gokturkbabaoglu/dumble-clone/parca-gorselleri/README.md

# Parça görselleri

Satıcı sayfalarından alınmış ürün görselleri ve çizimler. Çizimdeki ölçüler satıcınındır; **elindeki parçayla kumpasla doğrulanmadan kesin sayılmamalı**.

| Dosya | Parça | Not |
|---|---|---|
| `01_giris_jaki_6.35mm_olculer.png` | J1, 6,35 mm jak | Ölçü çizimi ve PCB delik planı |
| `02_giris_jaki_6.35mm_bacaklar.png` | J1, 6,35 mm jak | Bacak görevleri (görsel stereo sürüm; elindeki mono, 3 bacaklı) |
| `03_kulaklik_jaki_PJ-324_olculer.png` | J2, PJ-324M | Ölçü çizimi ve PCB yerleşimi |
| `04_kulaklik_jaki_PJ-324_bacaklar.png` | J2, PJ-324M | Bacak numaraları ve kesici kontaklar |
| `05_dc_jak_panel_3uclu.png` | DC giriş jakı | Panel tipi, 3 uçlu |
| `06_guc_anahtari_kirmizi_ON-ON_6bacak.png` | SW2 güç anahtarı | Kırmızı, ON-ON, 6 bacak |
| `07_SW1_mavi_anahtar_3bacak.png` | SW1 Dark/Normal/Bright | Mavi, 3 bacak. Kullanıcı ON-OFF-ON dedi; görselde gövdede "ON ON" yazıyor, orta konumu elindeki parçada doğrula |
| `08_TDA2003_klips_sogutucu.png` | U2 soğutucu | Klips tipi |

Potların, elektrolitiklerin ve sigorta yuvasının görseli yok.
