gokturkbabaoglu/dumble-clone/docs/6_toner_transfer_1e1.pdf

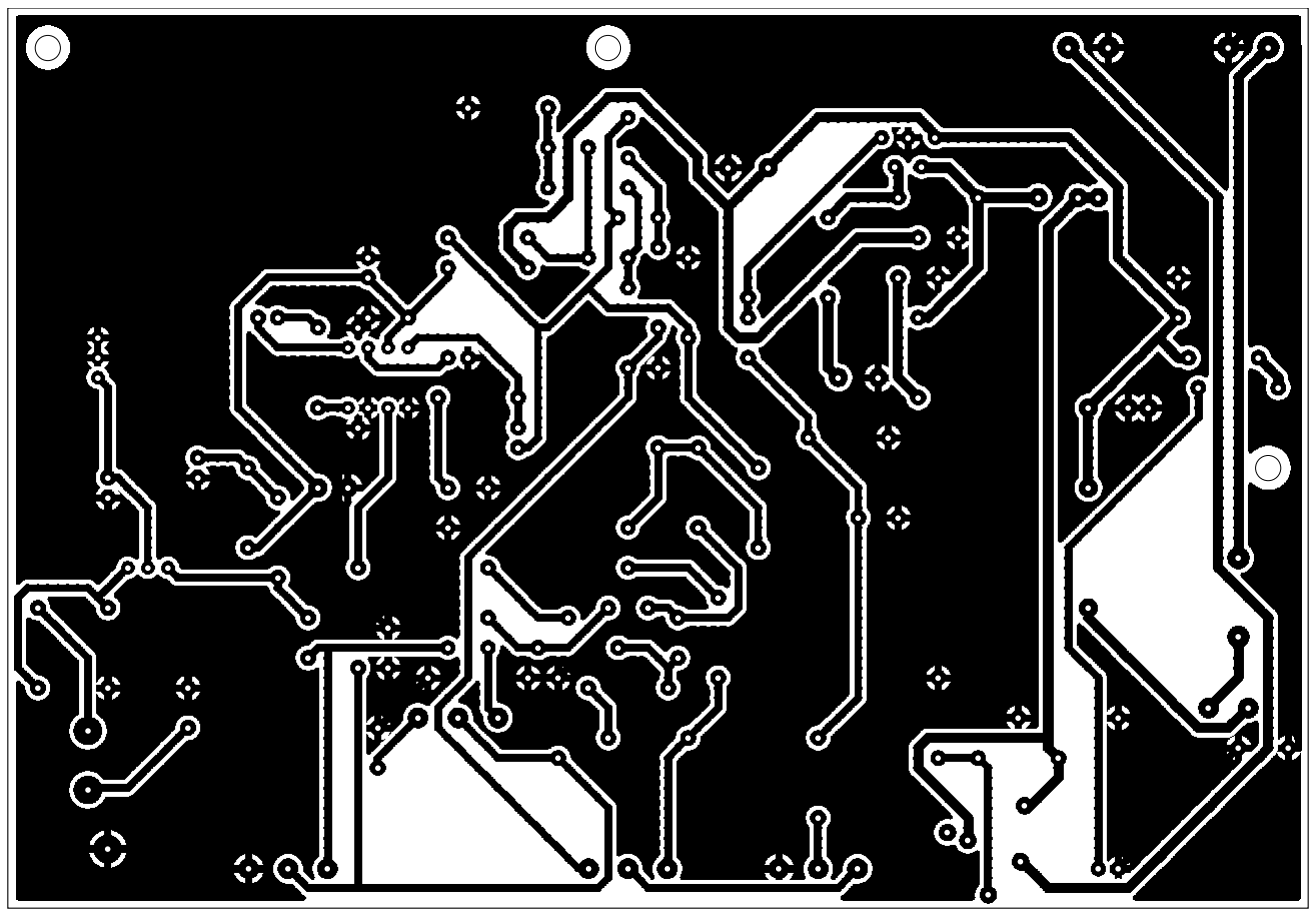
[picture p10: figure]

0 | 10 | 20 | 30 | 40 | 50

# 12V Gitar Amfisi v2 — BAKIR KATMANI, TONER TRANSFERİ İÇİN (1:1)

Yazdırırken ölçeklendirme KAPALI (%100 / Gerçek boyut). 50 mm cetvelini kumpasla kontrol et.

Bu görüntü zaten doğru yönde: kâğıt yüzü bakıra gelecek şekilde konunca bakırda alttan bakış oluşur.

Kart ölçüsü: 165.1 × 114.3 mm. Delmeden önce: jakları, potları ve büyük elkoları bu çıktının ön yüz görseliyle karşılaştır.
