gokturkbabaoglu/dumble-clone/parca-gorselleri/01_giris_jaki_6.35mm_olculer.png

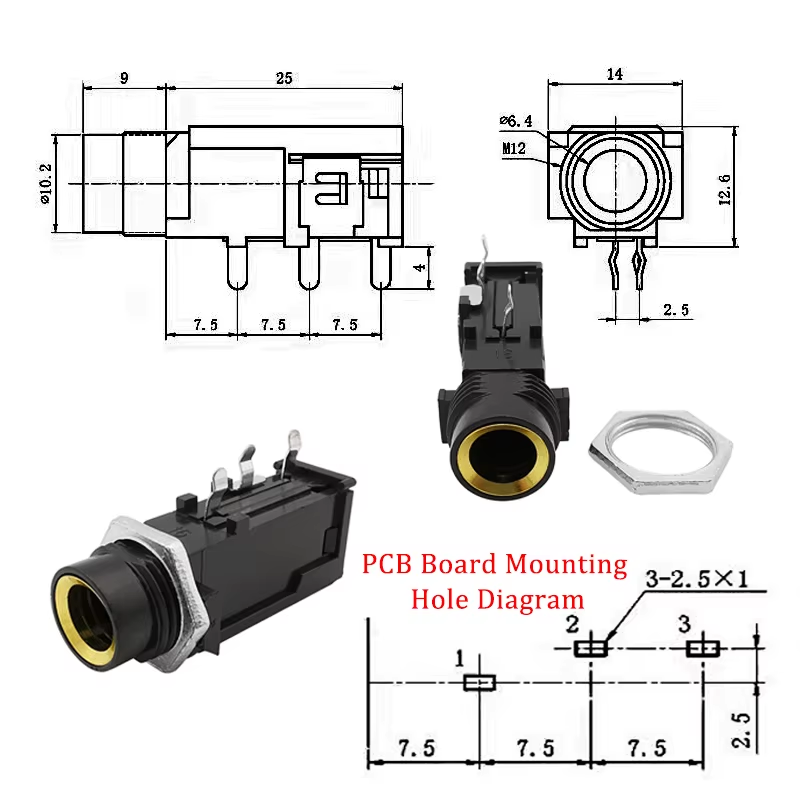
parca-gorselleri/01_giris_jaki_6.35mm_olculer.png
