gokturkbabaoglu/dumble-clone/parca-gorselleri/02_giris_jaki_6.35mm_bacaklar.png

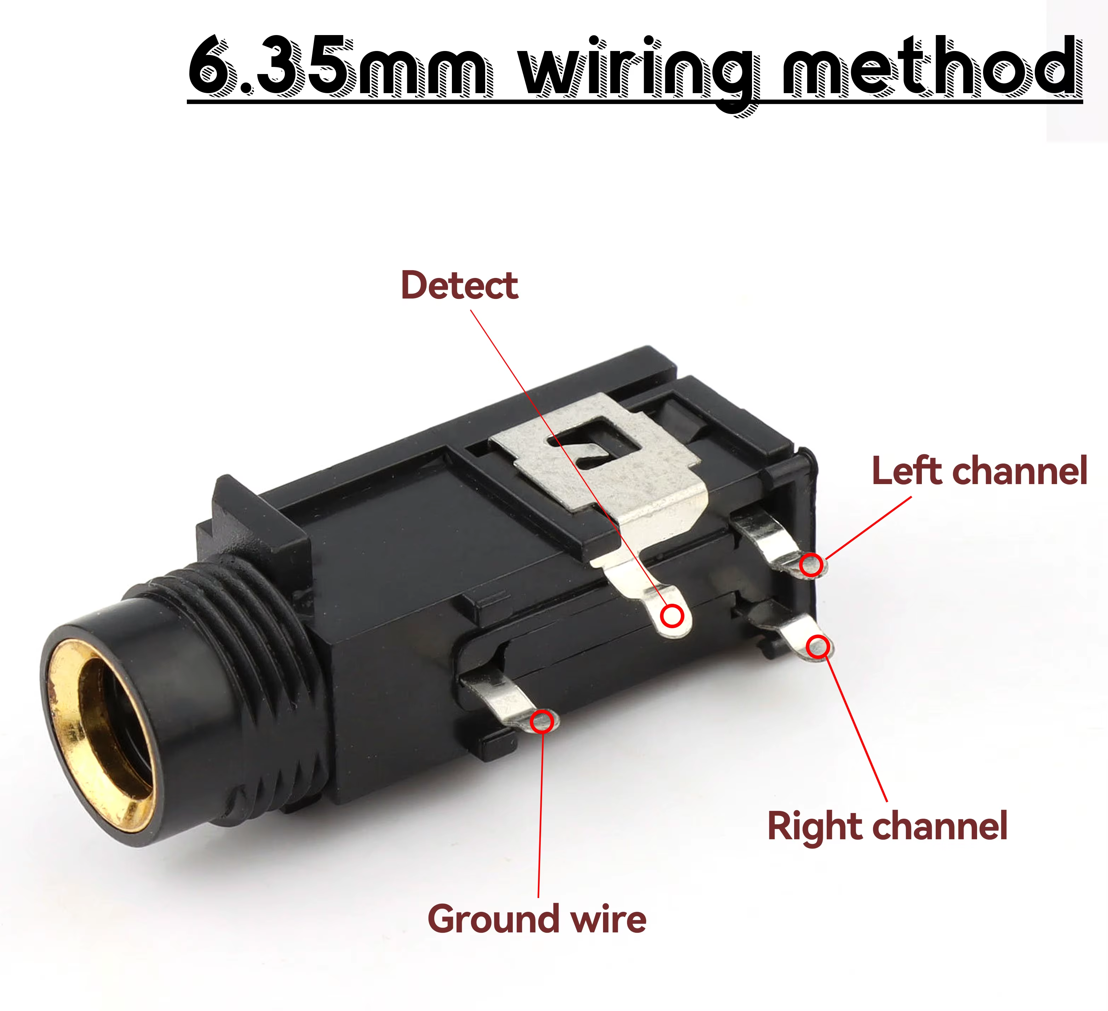
parca-gorselleri/02_giris_jaki_6.35mm_bacaklar.png
