gokturkbabaoglu/dumble-clone/parca-gorselleri/03_kulaklik_jaki_PJ-324_olculer.png

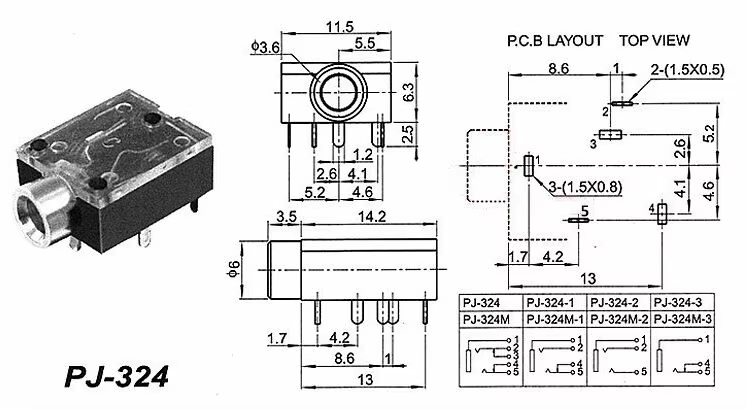
parca-gorselleri/03_kulaklik_jaki_PJ-324_olculer.png
