gokturkbabaoglu/dumble-clone/parca-gorselleri/04_kulaklik_jaki_PJ-324_bacaklar.png

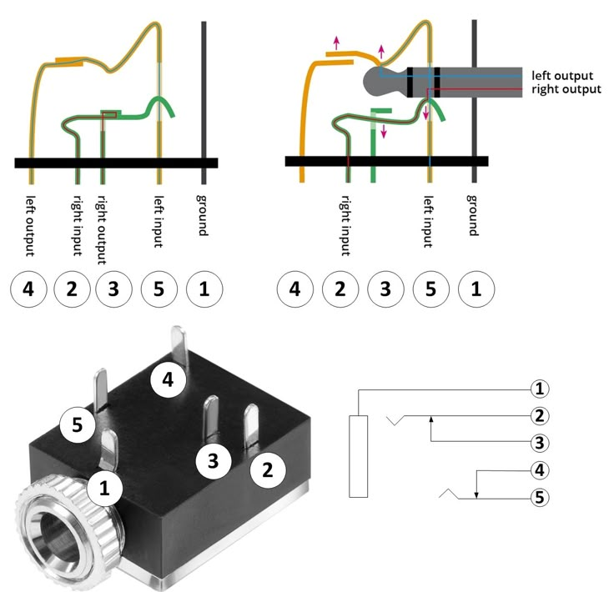
parca-gorselleri/04_kulaklik_jaki_PJ-324_bacaklar.png
