gokturkbabaoglu/dumble-clone/parca-gorselleri/05_dc_jak_panel_3uclu.png

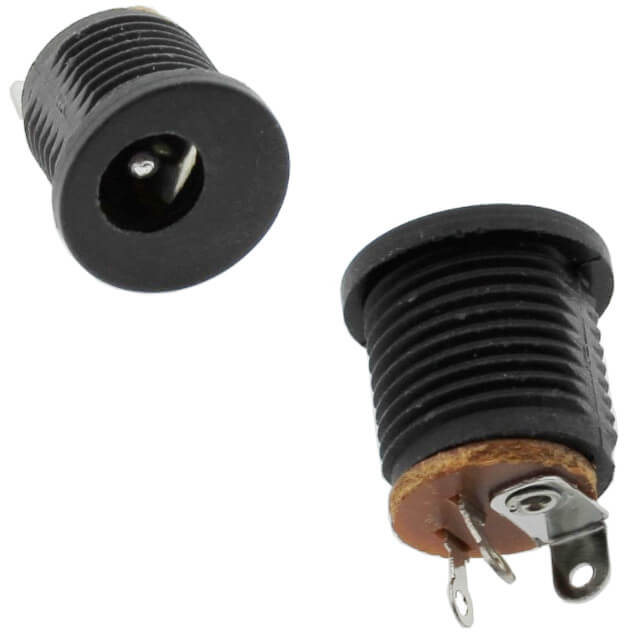
parca-gorselleri/05_dc_jak_panel_3uclu.png
