gokturkbabaoglu/dumble-clone/parca-gorselleri/06_guc_anahtari_kirmizi_ON-ON_6bacak.png

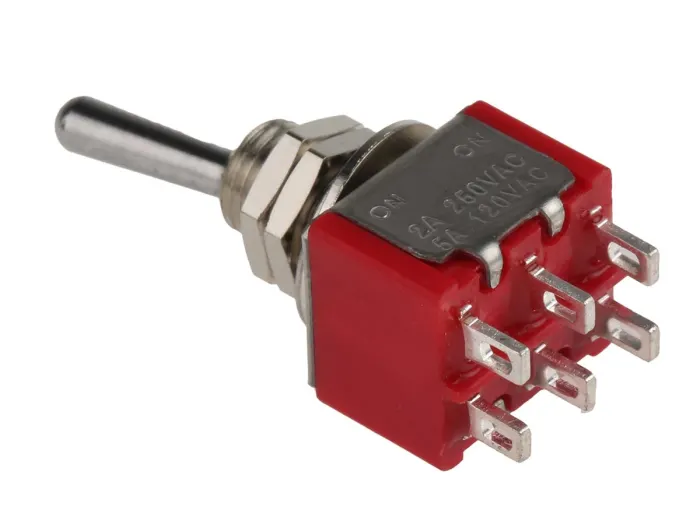
parca-gorselleri/06_guc_anahtari_kirmizi_ON-ON_6bacak.png
