gokturkbabaoglu/dumble-clone/parca-gorselleri/07_SW1_mavi_anahtar_3bacak.png

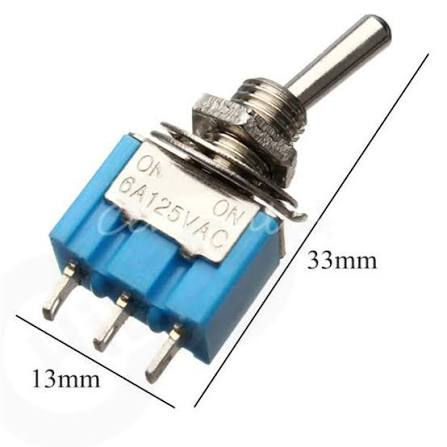
parca-gorselleri/07_SW1_mavi_anahtar_3bacak.png
