gokturkbabaoglu/dumble-clone/parca-gorselleri/08_TDA2003_klips_sogutucu.png

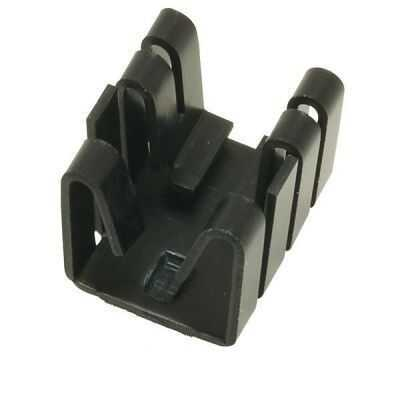
parca-gorselleri/08_TDA2003_klips_sogutucu.png
