gokturkbabaoglu/dumble-clone/sim/00_sema_genel.png

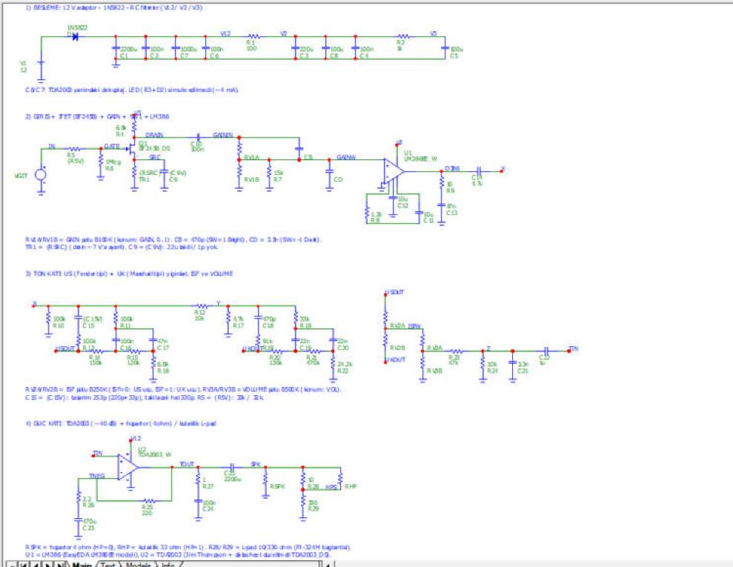
sim/00_sema_genel.png
