gokturkbabaoglu/dumble-clone/sim/01_dc_besleme_jfet_lm386.png

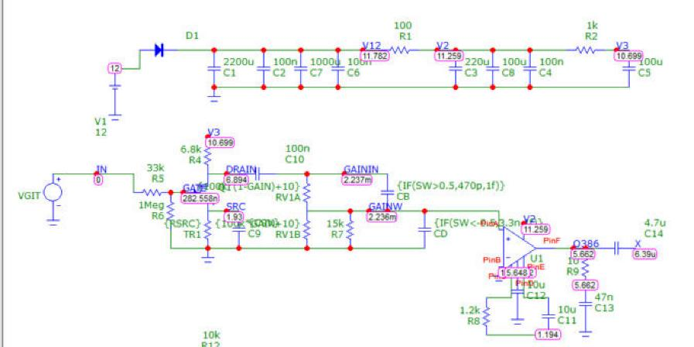
sim/01_dc_besleme_jfet_lm386.png
