gokturkbabaoglu/dumble-clone/sim/01_dc_isf_ve_guc_kati.png

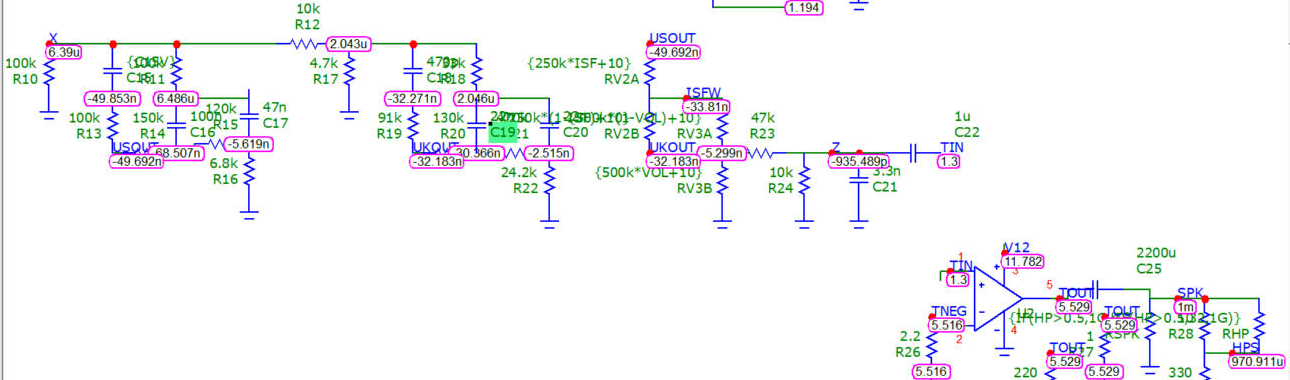
sim/01_dc_isf_ve_guc_kati.png
