gokturkbabaoglu/dumble-clone/sim/02_AC/02a_SW1.png

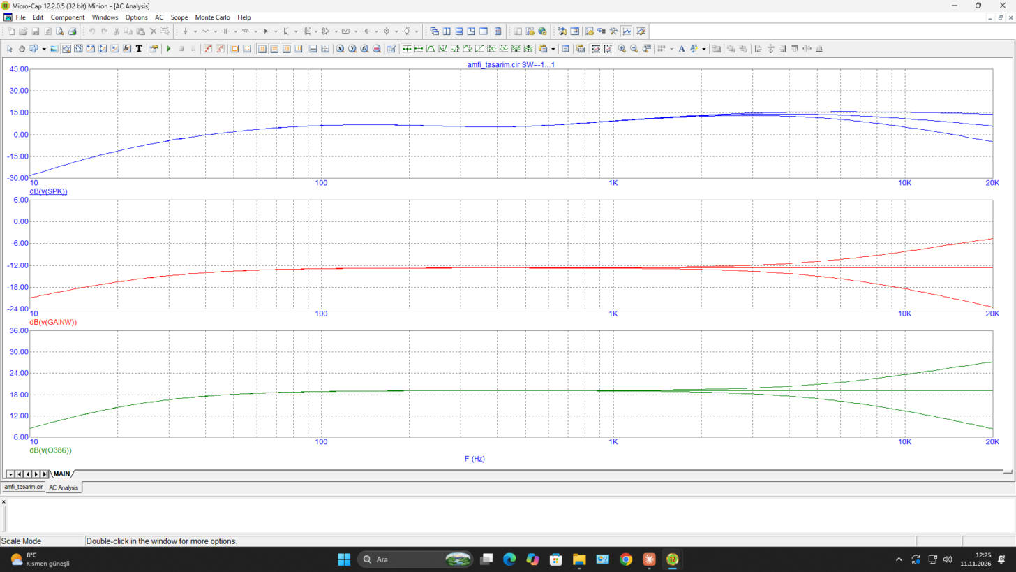
sim/02_AC/02a_SW1.png
