gokturkbabaoglu/dumble-clone/sim/02_AC/02b_kat_kazanclari.jpg

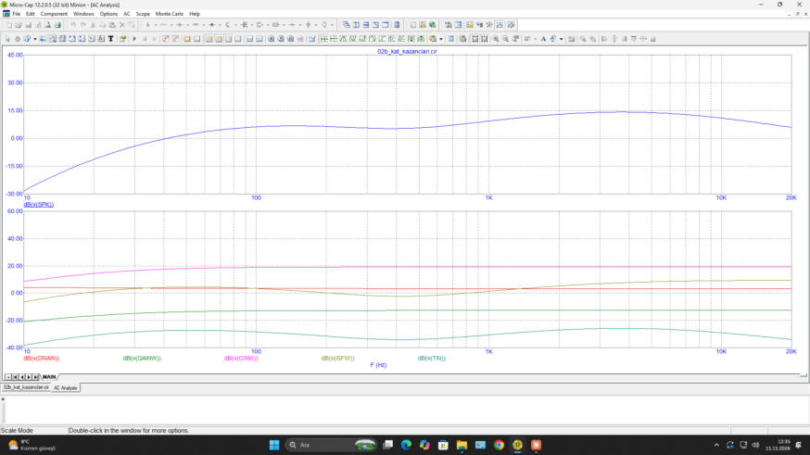
sim/02_AC/02b_kat_kazanclari.jpg
