gokturkbabaoglu/dumble-clone/sim/02_AC/02c_ISF.jpg

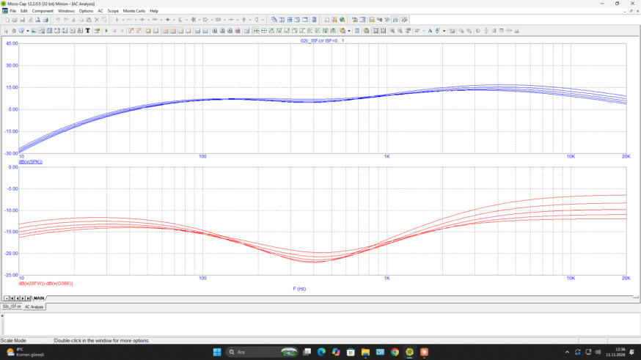
sim/02_AC/02c_ISF.jpg
