gokturkbabaoglu/dumble-clone/sim/02_AC/02d_GAIN.jpg

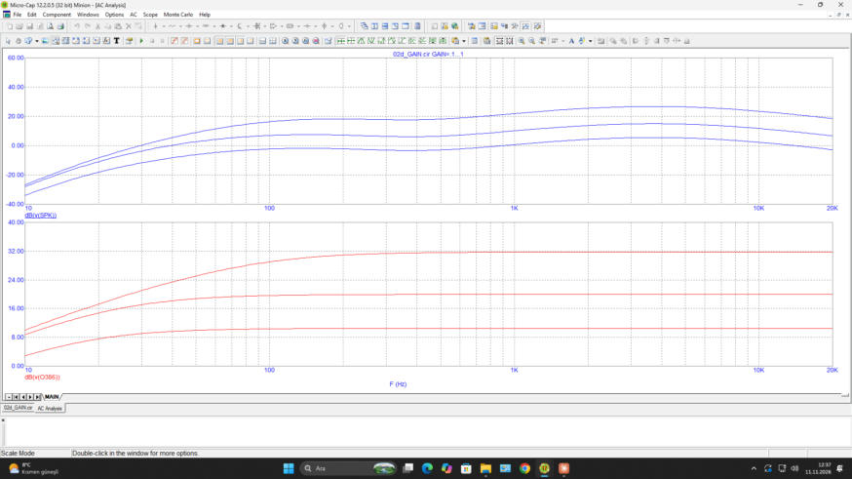
sim/02_AC/02d_GAIN.jpg
