gokturkbabaoglu/dumble-clone/sim/02_AC/02e_VOLUME.jpg

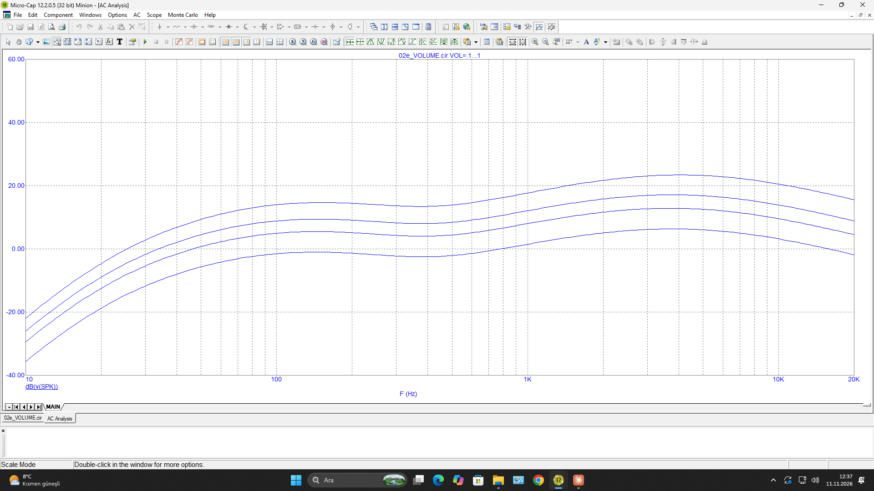
sim/02_AC/02e_VOLUME.jpg
