gokturkbabaoglu/dumble-clone/sim/02_AC/02f_C15_R5_asbuilt.jpg

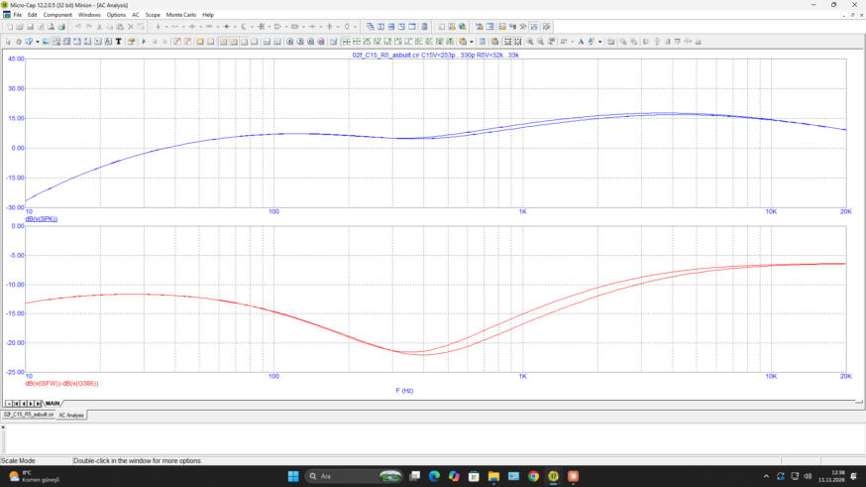
sim/02_AC/02f_C15_R5_asbuilt.jpg
