gokturkbabaoglu/dumble-clone/sim/03_TR/03a_transient.jpg

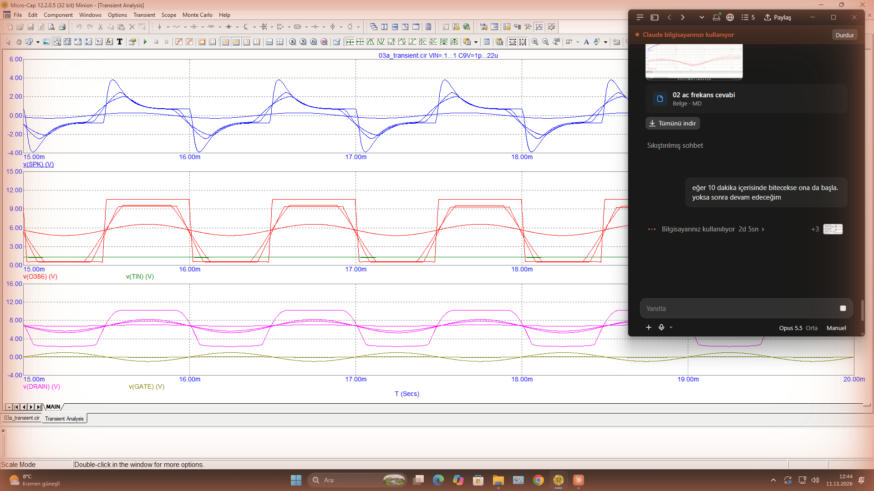
sim/03_TR/03a_transient.jpg
