gokturkbabaoglu/dumble-clone/sim/03_TR/03b_tam_guc_THD.jpg

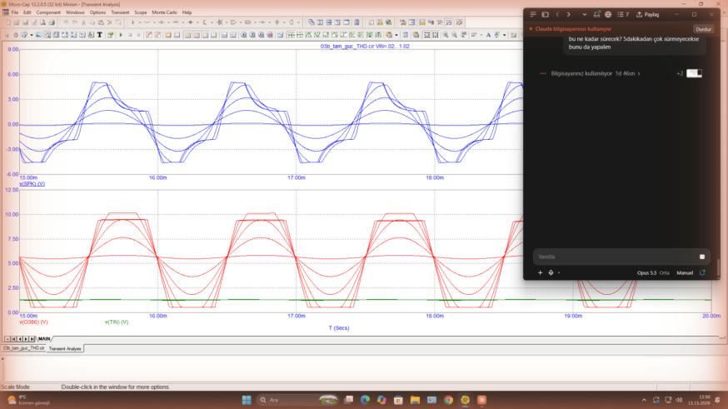
sim/03_TR/03b_tam_guc_THD.jpg
