gokturkbabaoglu/dumble-clone/sim/04_THD/04a_THD_gain_C9.jpg

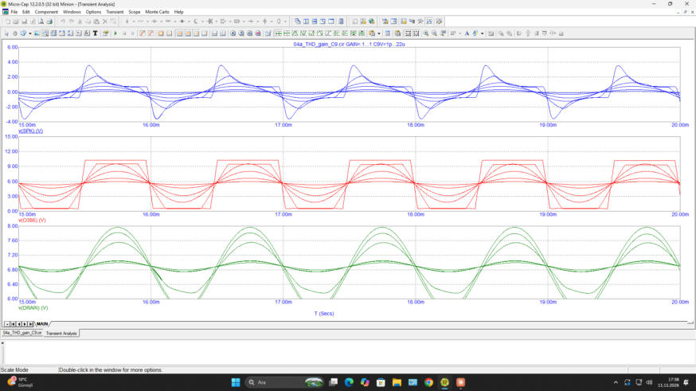
sim/04_THD/04a_THD_gain_C9.jpg
