gokturkbabaoglu/dumble-clone/sim/05_NOISE/05a_gurultu.jpg

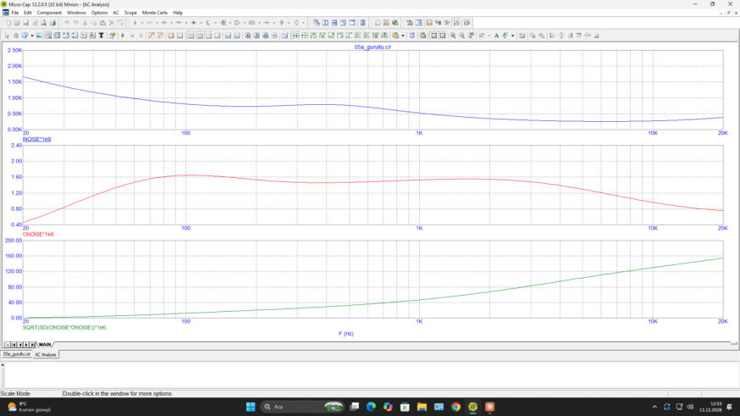
sim/05_NOISE/05a_gurultu.jpg
