gokturkbabaoglu/dumble-clone/sim/06_IMP/06a_empedans.jpg

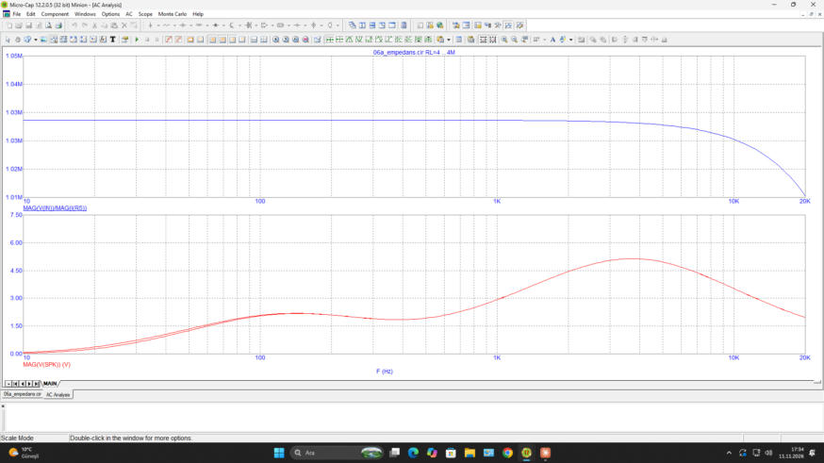
sim/06_IMP/06a_empedans.jpg
