gokturkbabaoglu/dumble-clone/sim/06_IMP/06b_kulaklik.jpg

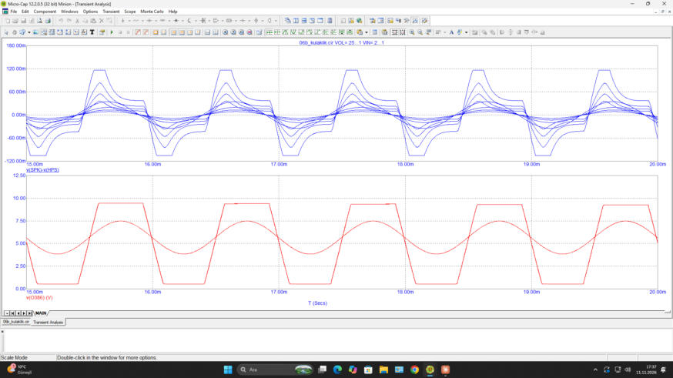
sim/06_IMP/06b_kulaklik.jpg
