gokturkbabaoglu/dumble-clone/sim/06_IMP/06c_besleme_ripple.jpg

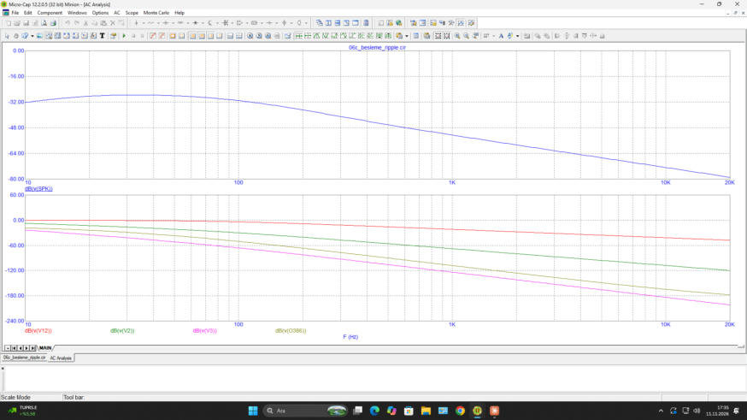
sim/06_IMP/06c_besleme_ripple.jpg
