gokturkbabaoglu/dumble-clone/sim/06_IMP/06d_TDA_kararlilik.jpg

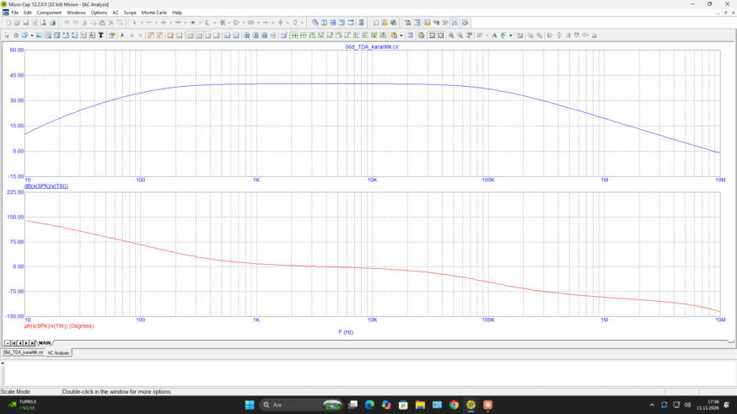
sim/06_IMP/06d_TDA_kararlilik.jpg
