gokturkbabaoglu/dumble-clone/sim/07_C9/07a_C9_AC.jpg

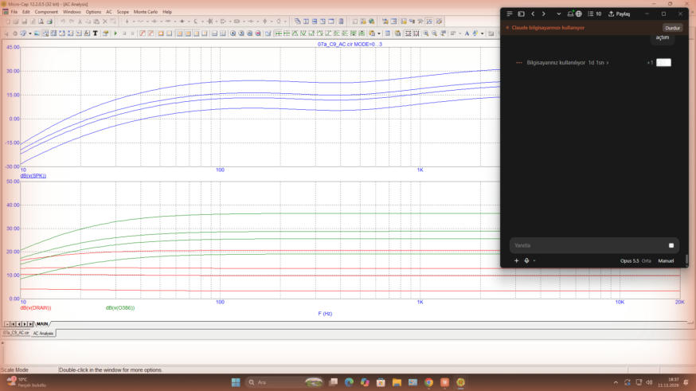
sim/07_C9/07a_C9_AC.jpg
