gokturkbabaoglu/dumble-clone/sim/07_C9/07b_C9_THD.jpg

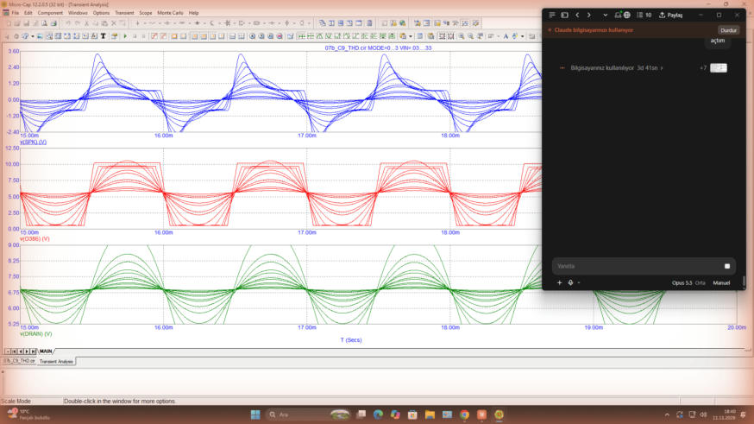
sim/07_C9/07b_C9_THD.jpg
