gokturkbabaoglu/dumble-clone/sim/07_C9/07c_C9_gurultu.jpg

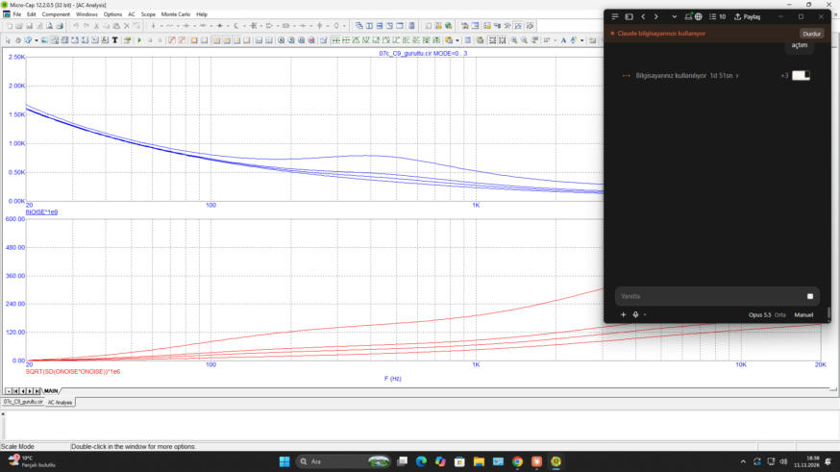
sim/07_C9/07c_C9_gurultu.jpg
