gokturkbabaoglu/dumble-clone/sim/08_POT/08a_pot_kazanc.jpg

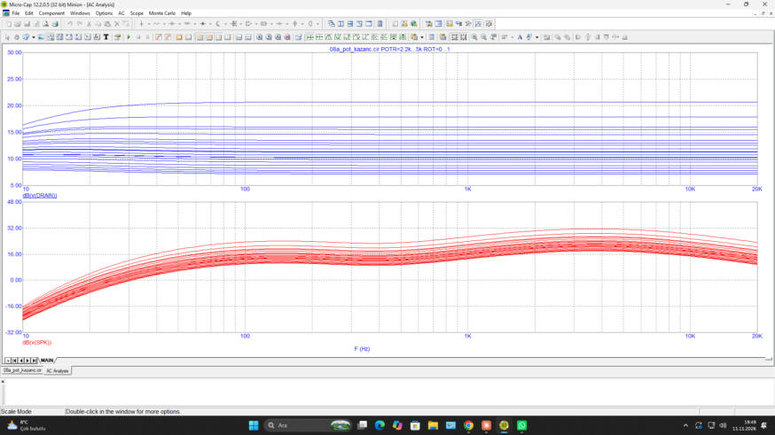
sim/08_POT/08a_pot_kazanc.jpg
