gokturkbabaoglu/dumble-clone/sim/08_POT/08b_pot_THD.jpg

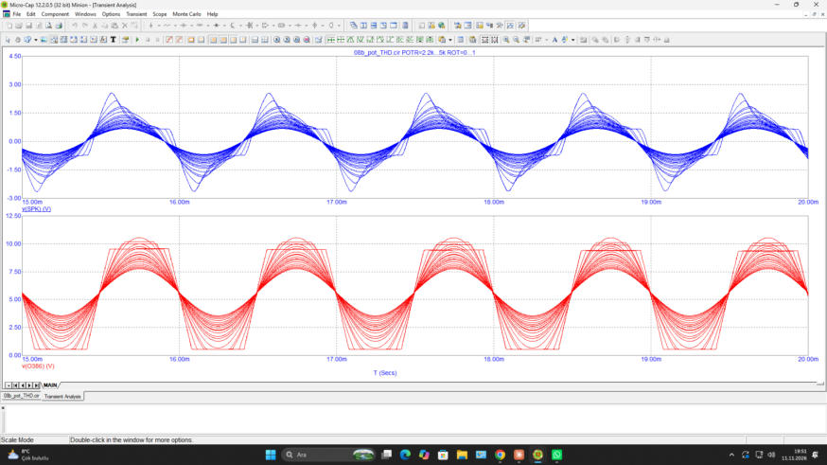
sim/08_POT/08b_pot_THD.jpg
