gokturkbabaoglu/dumble-clone/sim/09_KARSILASTIRMA/09a_ton_katlari.jpg

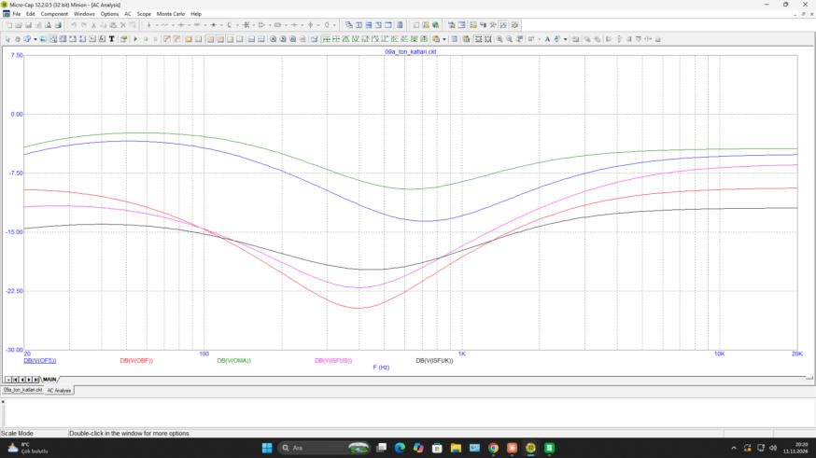
sim/09_KARSILASTIRMA/09a_ton_katlari.jpg
