gokturkbabaoglu/dumble-clone/eski/v1/docs/6_toner_transfer_1e1.pdf

## 12V Gitar Amfisi — BAKIR KATMANI, TONER TRANSFERİ İÇİN (1:1)

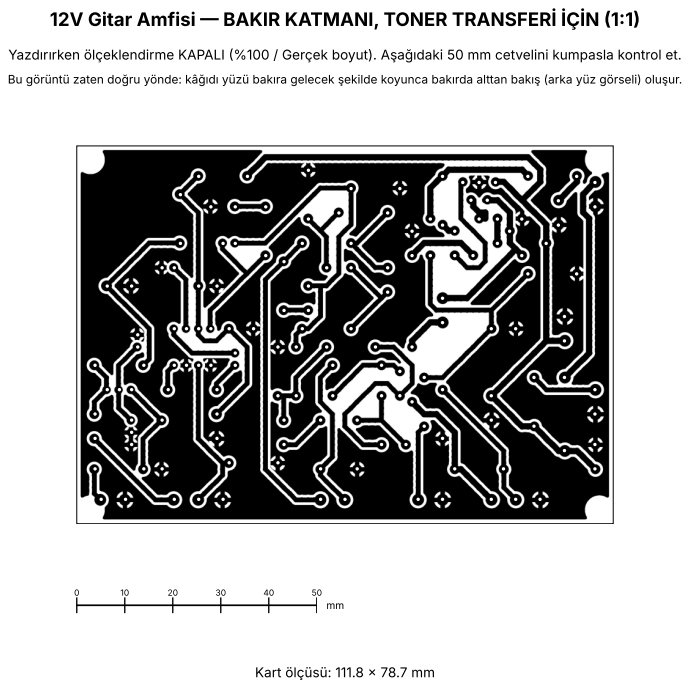
[picture p42: page 1]

Yazdırırken ölçeklendirme KAPALI (%100 / Gerçek boyut). Aşağıdaki 50 mm cetvelini kumpasla kontrol et.

Bu görüntü zaten doğru yönde: kâğıdı yüzü bakıra gelecek şekilde koyunca bakırda alttan bakış (arka yüz görseli) oluşur.

Kart ölçüsü: 111.8 × 78.7 mm
