gokturkbabaoglu/dumble-clone/(commit log)

2026-11-03 LM386 Dumble tarzı amfi — revizyon 3
    Şema, pertinaks yerleşimi, kart dışı bağlantılar, proje dosyası ve çizim araçları.
    Claude-Session: https://claude.ai/code/session_01627LyPMxVTu3X22wTHhK5Z
2026-11-04 Revizyon 4: 2,2k/560 dirençler, C11 ve C12, güç LED'i
    - Rd 1k+1k -> 2,2k, RM 1k+1k -> 2,2k, Rb 1k||1k -> 560 ohm
    - LM386 pin 7 bypass (C11 10 uF) ve pin 6 dekuplaj (C12 100 nF)
    - Kabinde sarı güç LED'i (2,2k ile)
    - Şema, kart yerleşimi, kart dışı bağlantılar, proje dosyası ve README güncellendi
    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
2026-11-08 Revizyon 5: 12 V BF245B + LM386 + TDA2003 amfi, ISF ve baskı devre
    Önceki LM386 + pertinaks tasarımının yerine sıfırdan yeni proje:
    - Şema: BF245B giriş katı, LM386 gain katı, ISF (US/UK ton yığınları),
    volume, TDA2003 güç katı, Dark/Normal/Bright, 3,5 mm kulaklık (L-pad)
    - Tek yüzlü baskı devre 112x79 mm, 4 tel köprü, GND dolgusu,
    netlist bağlantı doğrulaması
    - Ön panel ve besleme kablolama görselleri, 1:1 toner PDF'i
    - Proje dosyası ve yazdırılabilir alışveriş listesi
    Claude-Session: https://claude.ai/code/session_01627LyQQwMn43B1jqJv1njQ
2026-11-10 README: elektrolitik gerilimi, hoparlör, LED, pot tipi, kutu ve sigorta notları
    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
2026-11-11 C9 + RV4 DRIVE (B2.2K) seri: şema ve malzeme listesi
    C9 22µF artık takılıyor ve RV4 B2.2K lineer potla seri (SRC → C9 → RV4 → GND).
    RV4 yalnızca JFET katının AC kazancını ayarlar (×3.1 … ×10.8), TR1 DC
    çalışma noktası değişmez. Kart yerleşimi bu değişiklikte güncellenmedi.
    Claude-Session: https://claude.ai/code/session_01627LyPYRY1S9rxWCZWnTTf
2026-11-11 Micro-Cap simülasyonları: sim/ klasörü
    DC, AC, transient, THD, gürültü, empedans/kulaklık/besleme/kararlılık,
    C9 ve RV4 DRIVE karşılaştırmaları, Fender/Marshall ton katı ve diğer
    amfilerle karşılaştırma. Raporlar, Micro-Cap dosyaları, çıktılar ve
    model kütüphanesi.
    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
    [02a_SW1.csv, 02b_kat_kazanclari.csv, 02c_ISF.csv, 02d_GAIN.csv, 02e_VOLUME.csv, 02f_C15_R5_asbuilt.csv, 02g_C9.csv, 03a_transient.csv]
